metaboonma/MR32-BOT/Presentation/MR32-BOT and KB-IDE 4 page.pdf

14/08/63

1

# การใช้ KB-IDE ในการเขียนโปรแกรมควบคุมหุ่นยนต์ ด้วยบอร์ด MR32-BOT

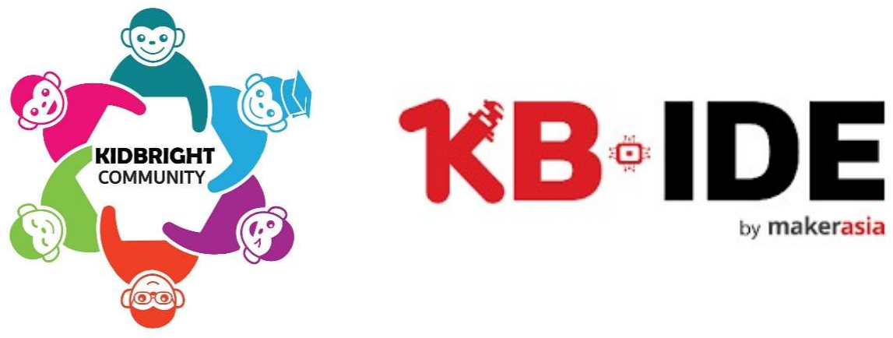
[picture p1: figure]

BY MR. META BOONMA | MTB
POWERED by | MICROTECHBEING
Introduction

## ประวัติผู้บรรยาย

ชือ นายเมธา บุญมา (Mr. Meta Boonma)
การศึกษา 2018 : มหาวิทยาลัยเทคโนโลยีพระจอมเกล้าพระนครเหนือ | | ป.ตรี เทคโนโลยีวิศวกรรมอิเล็กทรอนิกส์คอมพิวเตอร์
2016 : วิทยาลัยเทคนิคสมุทรสงคราม | | ปวส. เทคโนโลยีระบบโทรคมนาคม
2013 : วิทยาลัยเทคนิคสมทุ รสงคราม | | ปวช. ช่างอิเลก็ ทรอนิกส์ ประสบการทํางาน
- R&D Engineer | @ FORTH TRACKING SYSTEM Co., Ltd.
- IoT Software Engineer | @ FreewillFX Co.,Ltd. | (ปจจุบัน) - Project manager | @ Medical Cannabis Monitoring Platform powered by MTB | (ปจจุบัน) ผลงาน - รางวัลรองชนะเลิศการแขง่ ขนั หุ่นยนต์ABU Robocon Contest Thailand ในป 2014 (Hoilod Robot team) - ออกแบบและพัฒนา Embedded system, Robotic board ด้วย Microcontroller, SoC, SiP - การใชช้ ิปประมวลผล DSP เพือควบคุมระบบเสียง(Sound System) ด้วย Android application
- ออกแบบ Power Management และ LOW Power สําหรับ Smart devices - ออกแบบผลิตภัณฑ์ Smart Electronic ด้วยระบบปฏิบัติการ Linux, RTOS (GPS, Fingerprint scan, Face recognition) - ออกแบบและพัฒนาอุปกรณ์ IoT บนเทคโนโลยีการสือสารข้อมูล LORA, NB-IoT, 3G/4G, WLAN - พัฒนา IoT Platform ในชือ Medical Cannabis Monitoring Platform powered by MTB | MTB
POWERED by | MICROTECHBEING

Introduction

ทําความรู้จักกับ KidBright

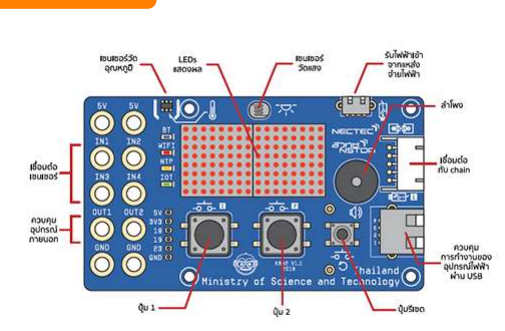
[picture p2: figure]

KidBrightเปนบอร์ดส่งเสรมิ การเรียนรู้พืนฐานของ การเขยีนโปรแกรม (Programming)
จุดเริมต้นจากโครงการสือการสอนโปรแกรมมิงในโรงเรียน (Coding at School Project) ของ กระทรวงวิทยาศาสตร์และเทคโนโลยี ซึงมีจุดม่งุ หมายในการพัฒนาศักยภาพระหว่าง ความคิดเชงิตรรกะ และความคดิ ริเรมสร้างสรรค์ ิ | ในลักษณะการเรียนรู้แบบ learn and play

## MTB

POWERED by | MICROTECHBEING

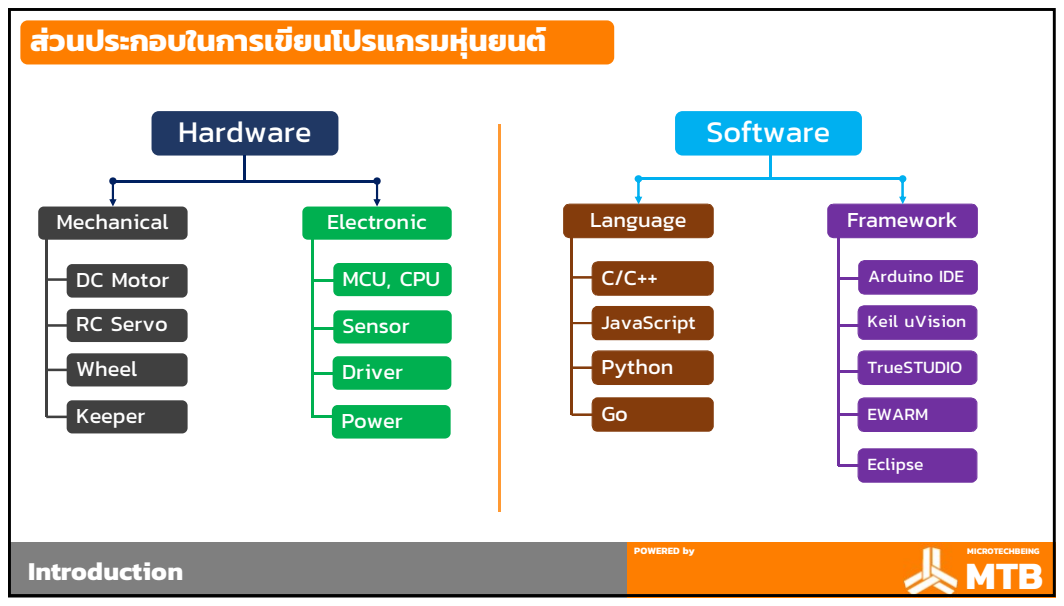
[picture p3: figure]
Introduction; ส่วนประกอบในการเขยีนโปรแกรมหุ่นยนต์; MTB; POWERED by; MICROTECHBEING; Hardware; Software; Mechanical; Electronic; DC Motor RC Servo Wheel Keeper; MCU, CPU Sensor; Power; Driver; Language; Framework; JavaScript Python

Go | Arduino IDE Keil uVision EWARM TrueSTUDIO Eclipse

2

Introduction

ทําความรู้จักกับ ESP32

## MTB

POWERED by | MICROTECHBEING
ESP32 เปนชิปไมโครคอนโทรลเลอรท์ มาพร้อม ี | WiFi และ Bluetooth 4.2 แบบ SoC (System on Chip) สามารถเขียน
โปรแกรมลงไปได้เลยไม่จําเปนต้องใช้ MCU อืนมาควบคุม ถูกพัฒนาโดยบริษัท Espressif โดย CPU ใช้สถาปตยกรรม Tensilica LX6 แบบ 2 แกนสมอง สัญญาณนาิกา 240MHz มีGPIO สําหรับต่อใช้งานจํานวน 32 ช่อง

สเปคของ ESP32
------------------------------------------------------------------------ - ซีพียูใช้สถาปตยกรรม Tensilica LX6 แบบ 2 แกนสมอง สัญญาณนาิกา 240MHz
- มีแรมในตัว 512KB
- รองรับการเชือมต่อรอมภายนอกสูงสุด 16MB
- มาพร้อมกับ WiFi มาตรฐาน 802.11 b/g/n รองรับการใช้งานทังใน
โหมด Station softAP และ Wi-Fi direct - มีบลูทูธในตวั รองรบั การใช้งานในโหมด 2.0 และโหมด 4.0 BLE
- มี GPIO จํานวน 32 ช่อง
- รองรับ UART จํานวน 3 ช่อง
- รองรับ SPI จํานวน 3 ชอ่ ง
- รองรับ I²C จํานวน 2 ชอ่ ง
- รองรับ ADC จํานวน 12 ช่อง
- รองรับ DAC จํานวน 2 ช่อง
- รองรับ I²S จํานวน 2 ช่อง
- รองรับ PWM / Timer ทุกช่อง
- รองรับการเชือมต่อกับ SD-Card

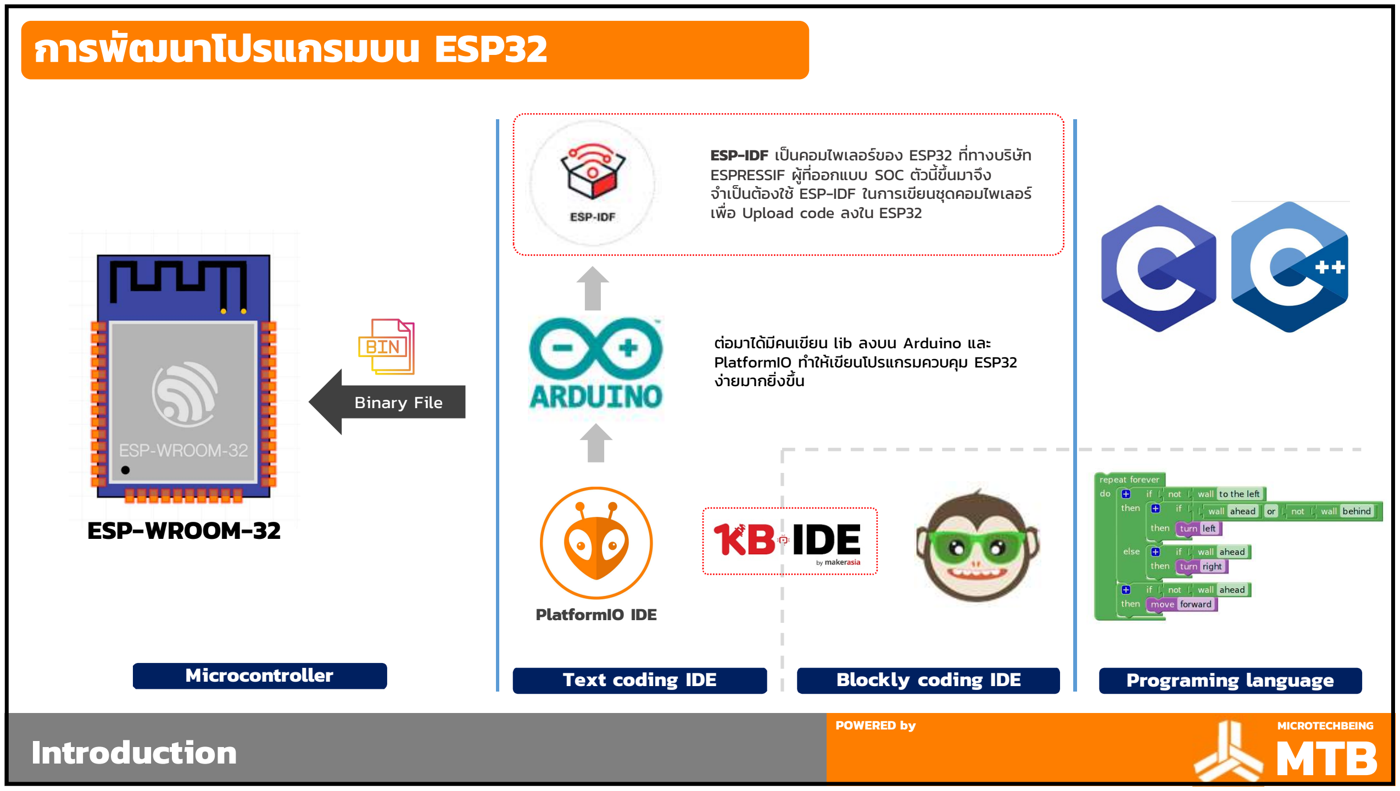
[picture p4: figure]
Introduction; การพัฒนาโปรแกรมบน ESP32; MTB; POWERED by; MICROTECHBEING; ESP-WROOM-32; PlatformIO IDE; Binary File Microcontroller; Text coding IDE; Blockly coding IDE; Programing language

ESP-IDF เปน คอมไพเลอรข์ อง ESP32 ทีทางบริษัท ESPRESSIF ผู้ทีออกแบบ SOC ตัวนีขึนมาจึง จําเปนต้องใช้ ESP-IDF ในการเขียนชุดคอมไพเลอร์ เพือ Upload code ลงใน ESP32 ต่อมาได้มีคนเขียน lib ลงบน Arduino และ PlatformIO ทําให้เขียนโปรแกรมควบคุม ESP32 ง่ายมากยิงขึน

Introduction

## ทาํ ความรู้จักกับ KB-IDE

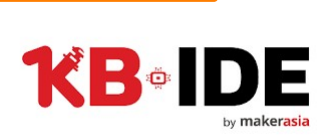
[picture p5: figure]

KB-IDE เปนโปรแกรมสัญชาตไิทยสําหรับใช้เขียนโปรแกรมบนบอร์ด IoT (และ SBC ด้วยในอนาคต) โดยเปาหมายการ ออกแบบคือ IDE สําหรับทุกคน ทกุ ระดับ เด็กๆ สามารถใช้Block Programming ได้มอื โปรสามารถใช้Code Editor ได้

เปน IDE ทีใช้ไดก้ ับทุกบอร์ดในตลาด ทสําคัญคือเป ี | น IDE ที Hackable นันหมายความว่านักพัฒนาสามารถเปลียนแปลง
หรือต่อยอด IDE ได้ไม่ว่าจะเปน Board Manager หรือ Plug-in ต่าง ๆ เนืองจาก KB-IDEเปน Open Source และ Open Architecture. | MTB
POWERED by | MICROTECHBEING

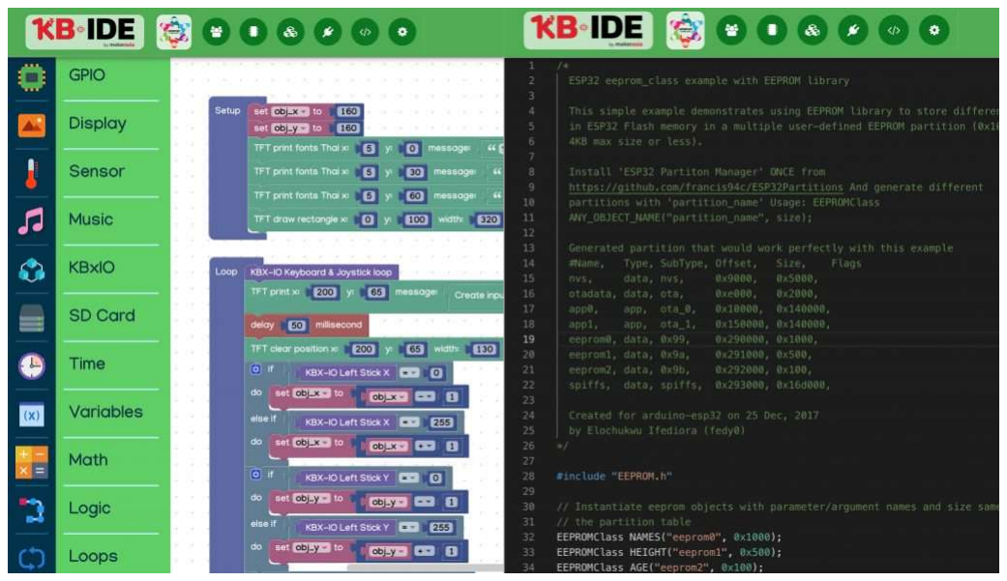
[picture p6: figure]

Introduction

ความสามมารถของ KB-IDE | - เขียนโปรแกรมไดท้ ังในแบบ Blocks Programming และ Code Editor - เพิม Hardware Board ได้ใน Board Manager - เพิม Framework ในการเขียนโปรแกรมได้ (ตอนนี support ESP-IDF และ Arduino) - เพิม Plugins และ Library ได้ - คอมไพล์เปน Native Code ทําให้ไม่มีข้อจํากดั ในด้าน ความเร็ว และสามารถคอมไพล์ได้เร็วกวา่ IDE ใน ตลาดปจจุบนั มากรวมทง ั Arduino IDE
- เครืองช่วยในการเขียนโปรแกรมต่าง ๆ เช่น Serial Console และ Serial Graph ทีพรอ้ มใช้งาน
- สามารถใช้ได้ทัง Mac, Windows และ Linux
- ตัวอย่างและ Tutorial พรอ้ มใช้งาน | MTB
POWERED by | MICROTECHBEING

3

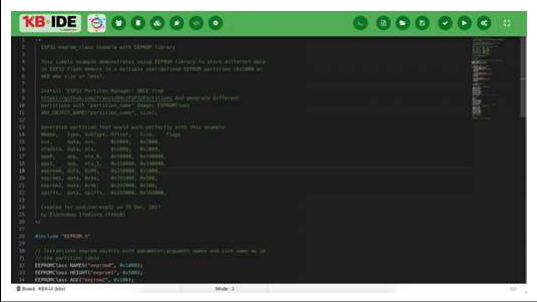
[picture p7: figure]

Introduction

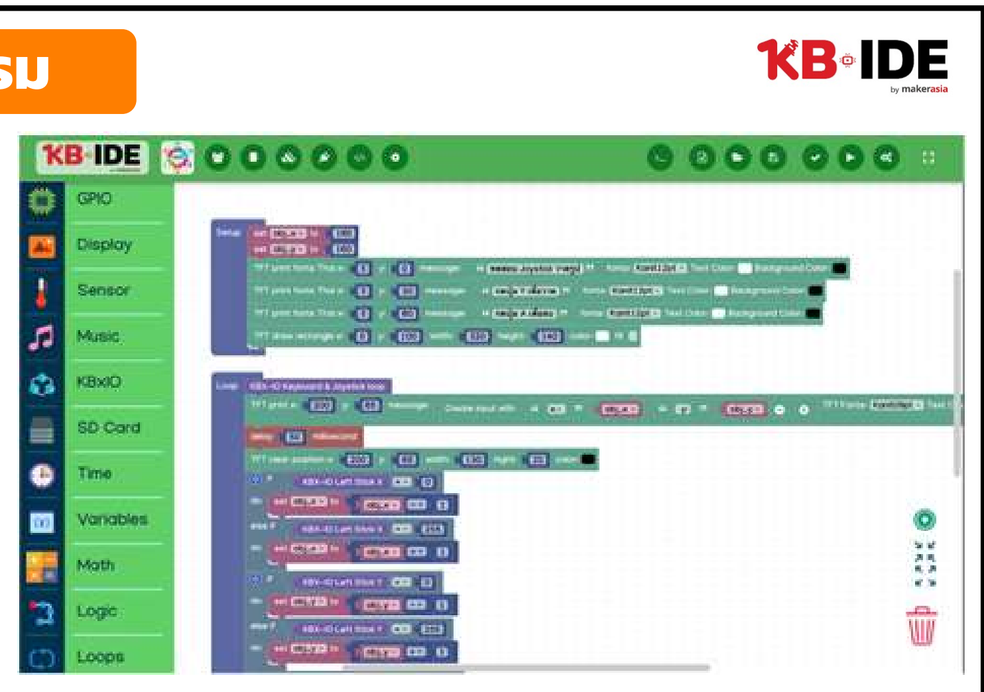
[picture p8: figure]

ความสามารถในแต่โหมดการเขียนโปรแกรม

## MTB

POWERED by | MICROTECHBEING

Text Programing
------------------------------------------------ – Speed up coding by converting C/C++ from block. – Line error hint, indicate and report lines with error. – 50+ editor themes, dark/light, select your personal preference. – Fast switch block & code mode. – External package, add a more powerful tool. | Block Programming

----------------------------------------------- – 100% no hardcoding, just drag & drop with block connection. – Easy and Intuitive. – Basic & Advance block coverage 99% of the code that you write. – Various helping blocks, Images, Music, Text-to-speech. – Have fun in exploring with your creativity. – Speed up text-coding, all blocks are 100% convertible ready-compile C/C++

Introduction

## ทําความร้จู ักกับบอร์ด MR32-BOT

## MTB

POWERED by | MICROTECHBEING

บอร์ดไมโครคอนโทรเลอร์MR32-BOT เปนบอร์ดทีพัฒนาขึนมาด้วยวัตถุประสงค์ที อยากใหก้ ารสร้างห่นุ ยนต์ขนาดเล็กง่ายมากยงขึ ิ นโดยไม่จาํ เปนต้องหาบอรด์ อืนๆมาตอ่ พ่วงกนั เพือทีจะลดปญหาของการเชือมต่อสายไฟผิดพลาด, ตอ่ แบตเตอรีผิดขัว, ขนาดของบอร์ด สําเร็จรูปในท้องตลาดมขี นาดใหญ่และราคาสูง
บอร์ดไมโครคอนโทรเลอร์ MR32-BOT จึงได้ถูกออกแบบมาให้ช่วยแก้ปญหาทีกล่าวมาใน ตอนต้นและยังช่วยลดเวลาในการพัฒนาโปรแกรมลงค่อนข้างมาก
ESP-WROOM-32 BT / WiFi | 2 Channel Motor driver RC Server Analog input Switch button USB to TTL programmable

Battery 3500mAh

Battery Charger ⁵V boost converter 2.1A LDO 3.3V 800mA ON/OFF Controller

5V/2.1A 3.3V 5V USB

MR32-BOT Architecture MR32-BOT Rev. A

Introduction

## ขาต่างๆของ MR32-BOT

## MTB

POWERED by | MICROTECHBEING GPIO¹⁸ GPIO¹⁹ GPIO²³

GPIO15 GPIO14 GPIO13 GPIO14 GPIO36 GPIO39 GPIO34 GPIO35 GPIO32 +3V3 GND ADC4 ADC7 ADC6 ADC3 ADC0

SERVO GPIO16 GND | +5V | GPIO17 GND | +5V | DC MOTOR2 LED DIR MOTOR2 DC MOTOR1 LED DIR MOTOR1 SWITCH POWER ON/OFF Micro USB

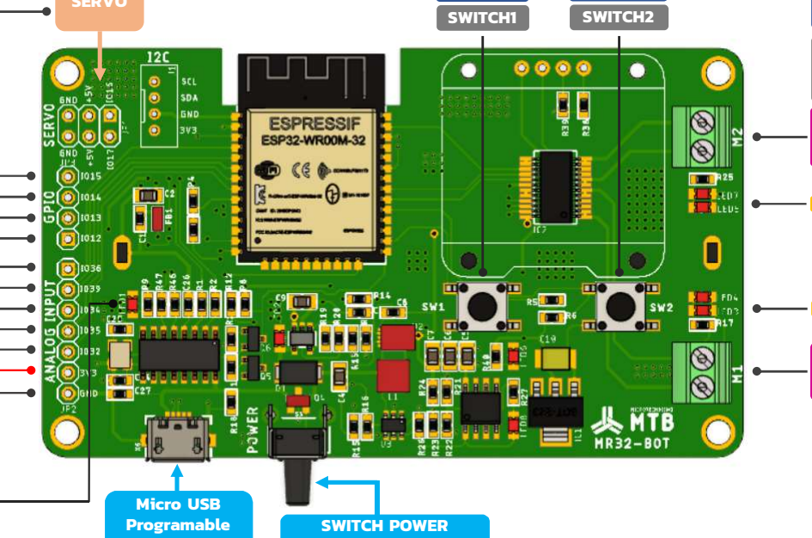
[picture p9: figure]

Programable and charge

SWITCH1 GPIO4 | SWITCH2 GPIO5 | A | PWM B A | PWM B GPIO²⁵ GPIO²⁶ GPIO²⁷ GPIO2 | LED BUITIN

BATTERY MONITOR GPIO33 ADC5 Voltage divider (R1=R2=22K) ** VBAT = VBAT / 2 **

KB-IDE

## การติดตังโปรแกรม KB-IDE https://kbide.org/

## MTB

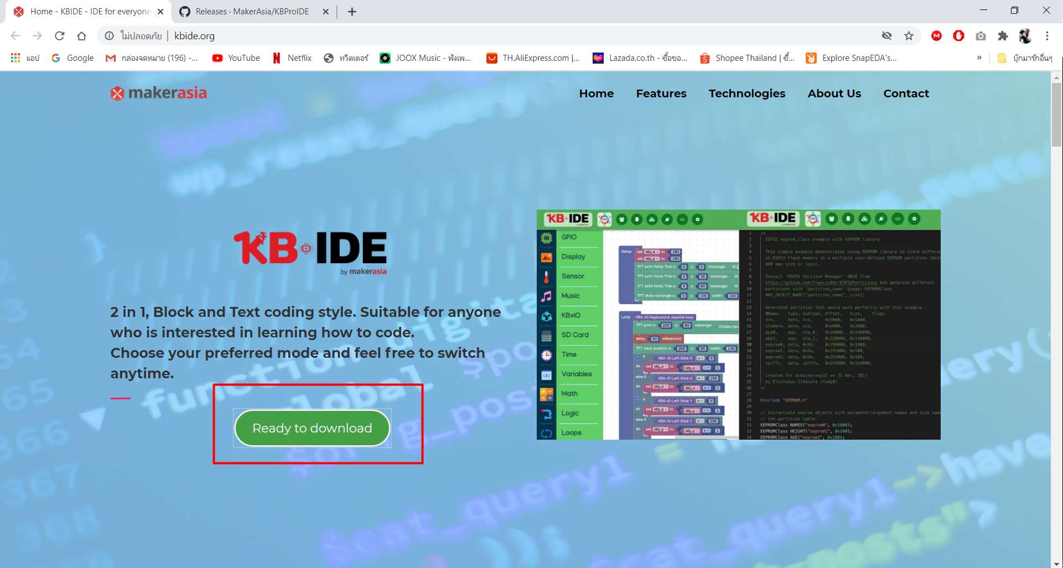
[picture p10: figure]

POWERED by | MICROTECHBEING

## การติดตังโปรแกรม KB-IDE โปรแกรม KB-IDE

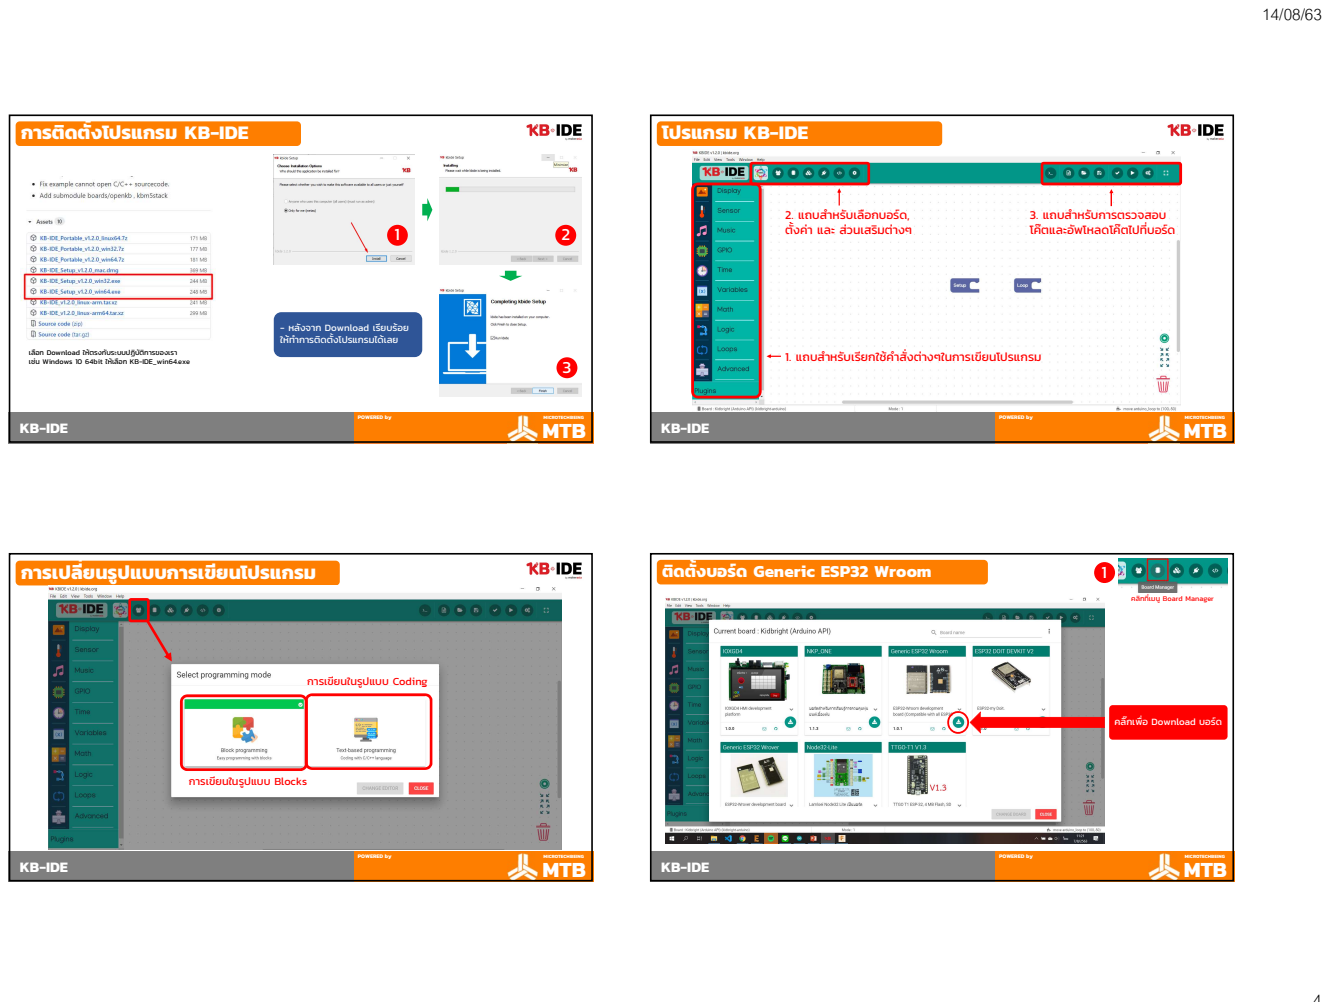
[picture p11: page 4]
KB-IDE; MTB; POWERED by; MICROTECHBEING; ตดิ ตังบอร์ด Generic ESP32 Wroom; คลิกทีเมนู Board Manager คลิกเพือ Download บอร์ด

2. แถบสําหรับเลือกบอร์ด, ตังค่า และ ส่วนเสริมต่างๆ

3. แถบสําหรับการตรวจสอบ
โค๊ตและอัพโหลดโค๊ตไปทีบอร์ด

- หลังจาก Download เรียบร้อย
ให้ทําการตดิ ตงโปรแกรมได้เลย ั

เลือก Download ให้ตรงกับระบบปฏิบัติการของเรา
เช่น Windows 10 64bit ให้เลือก KB-IDE_win64.exe

1. แถบสําหรับเรียกใช้คําสังต่างๆในการเขียนโปรแกรม

การเปลียนรูปแบบการเขียนโปรแกรม

การเขยี นในรูปแบบ Coding

การเขียนในรูปแบบ Blocks

5

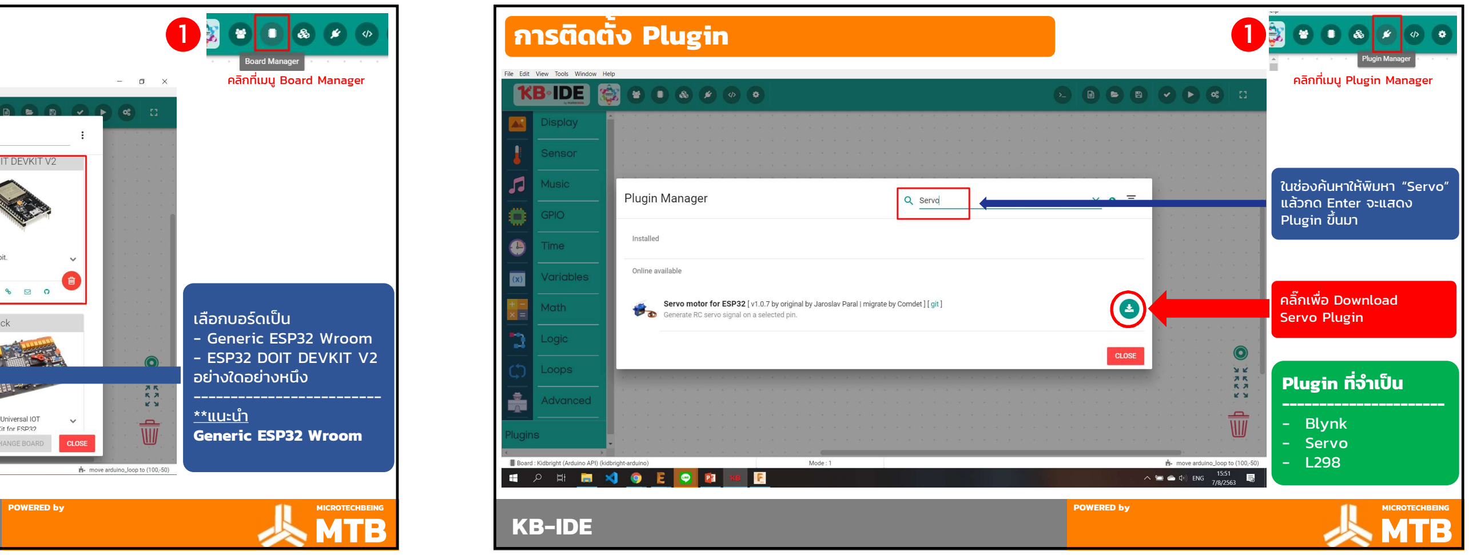
[picture p12: figure]
คลกิ ทเมนู ี; Board Manager; เลือกบอร์ดเปน - Generic ESP32 Wroom; - ESP32 DOIT DEVKIT V2 อย่างใดอย่างหนึง; ------------------------- **แนะนํา Generic ESP32 Wroom; MTB; POWERED by; MICROTECHBEING; KB-IDE; การติดตัง Plugin; คลิกทีเมนู Plugin Manager; คลิกเพือ Download Servo Plugin; ---------------------- - Blynk; - Servo - L298
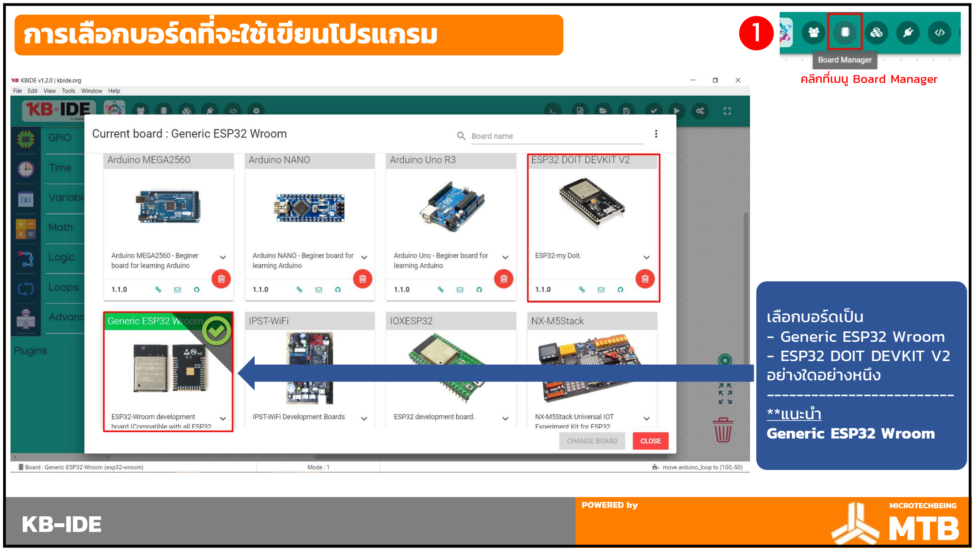
[picture p13: figure]
KB-IDE; การเลือกบอร์ดทีจะใช้เขียนโปรแกรม

ในช่องค้นหาให้พิมหา “Servo” แล้วกด Enter จะแสดง Plugin ขึนมา Plugin ทีจําเปน

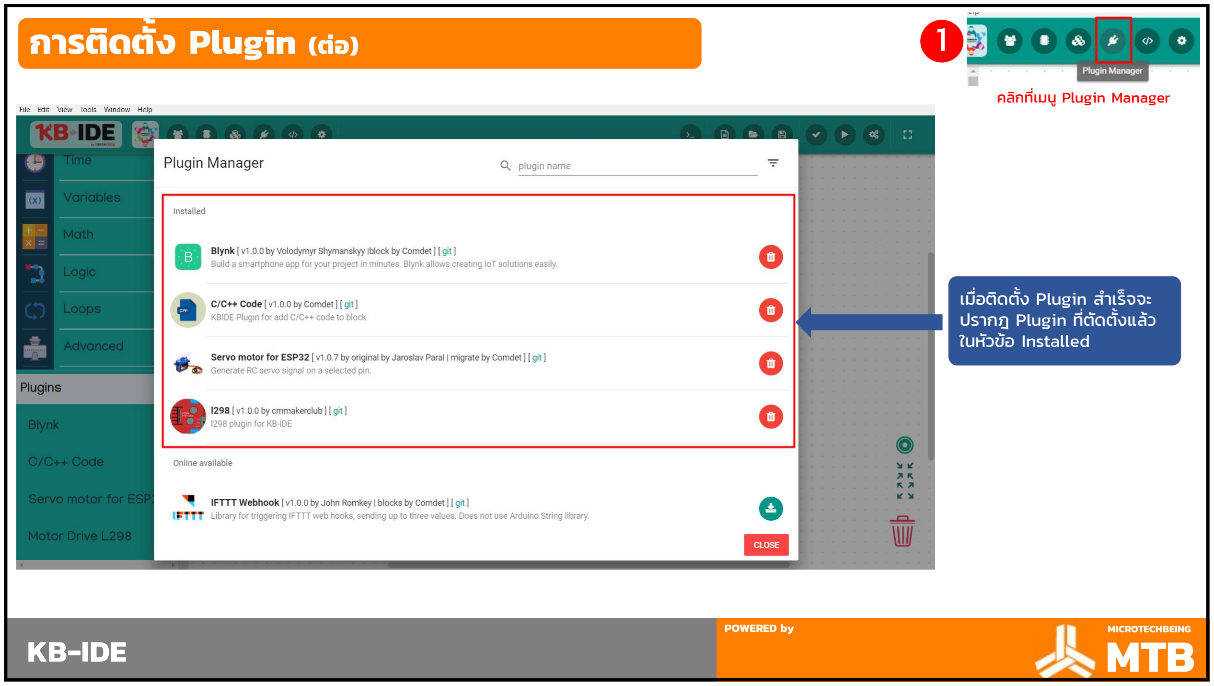
[picture p14: figure]
KB-IDE; การติดตัง Plugin (ต่อ); MTB; POWERED by; MICROTECHBEING; คลกิ ทเมนู ี; Plugin Manager; ในหัวข้อ Installed

เมือติดตัง Plugin สําเร็จจะ ปรากฎ Plugin ทีตัดตังแล้ว

KB-IDE

สรุปขันตอนการติดตังและตังค่าต่างๆ

## MTB

POWERED by | MICROTECHBEING

### 1. ติดตังโปรแกรม KB-IDE สามารถดาวโหลดได้จาก https://kbide.org/ 2. ติดตังบอร์ด Generic ESP32 Wroom 3. เลือกบอร์ดทีเราจะใช้ในการขยี นโปรแกรมในทนี ี คือ Generic ESP32 Wroom 4. ติดตัง Plugin ทีจําเปนต้องใช้ - Blynk

- Servo motor for ESP32
- L298

## ** หากทําการติดตังครบแลว้มาเริมเขียนโปรแกรมกัน **

6

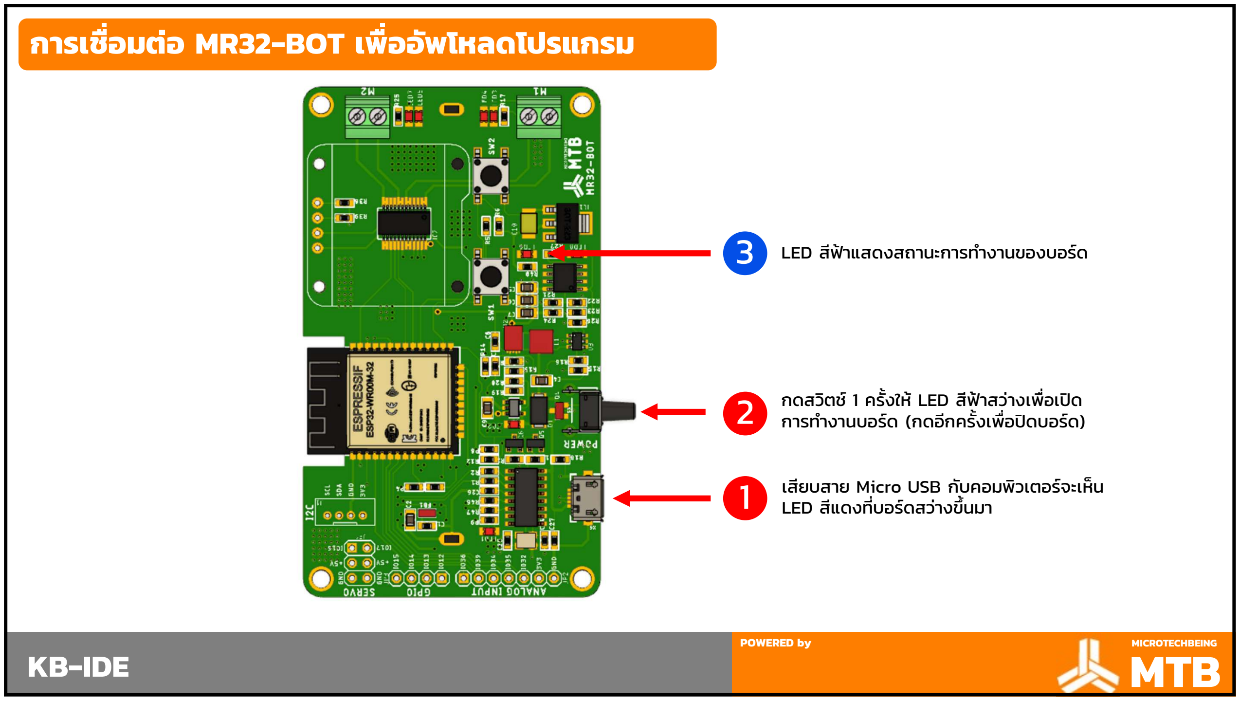
[picture p15: figure]
KB-IDE; การเชือมต่อ MR32-BOT เพืออัพโหลดโปรแกรม; MTB; POWERED by; MICROTECHBEING; 2 การทํางานบอร์ด (กดอีกครังเพือปดบอร์ด); 3 LED สีฟาแสดงสถานะการทํางานของบอร์ด 
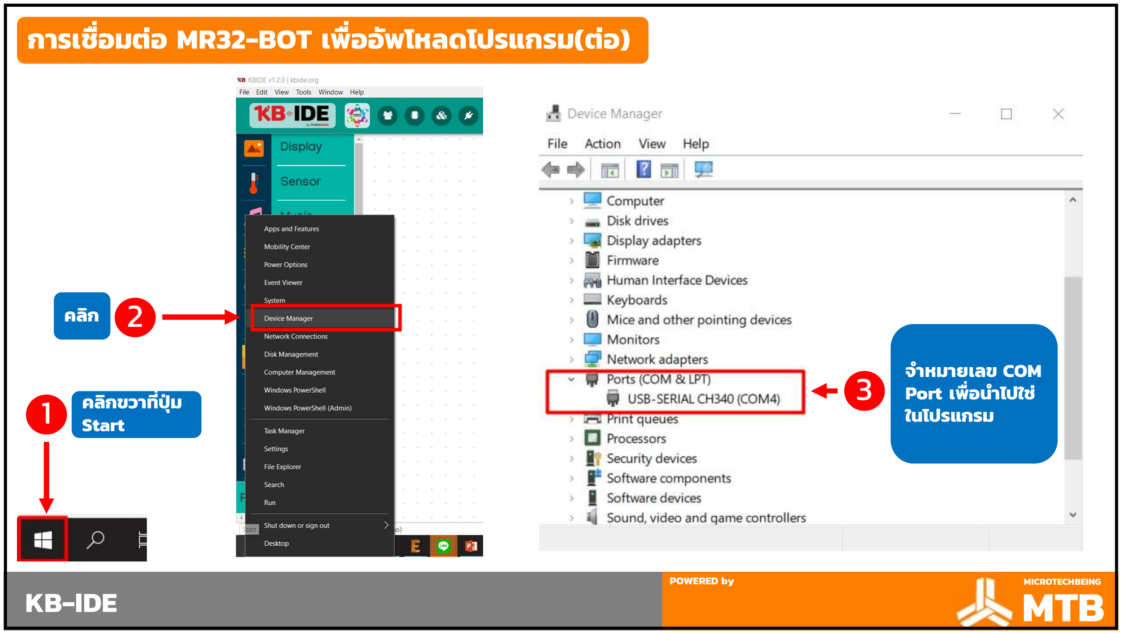
[picture p16: figure]
KB-IDE; การเชือมต่อ MR32-BOT เพืออพั โหลดโปรแกรม(ต่อ); MTB; POWERED by; MICROTECHBEING; คลิกขวาทีปุม Start 1 คลิก 2; จําหมายเลข COM Port เพือนําไปใช่ ในโปรแกรม

1 เสียบสาย Micro USB กับคอมพิวเตอร์จะเห็น LED สีแดงทีบอร์ดสว่างขึนมา กดสวิตช์1 ครังให้ LED สีฟาสว่างเพื อเปด

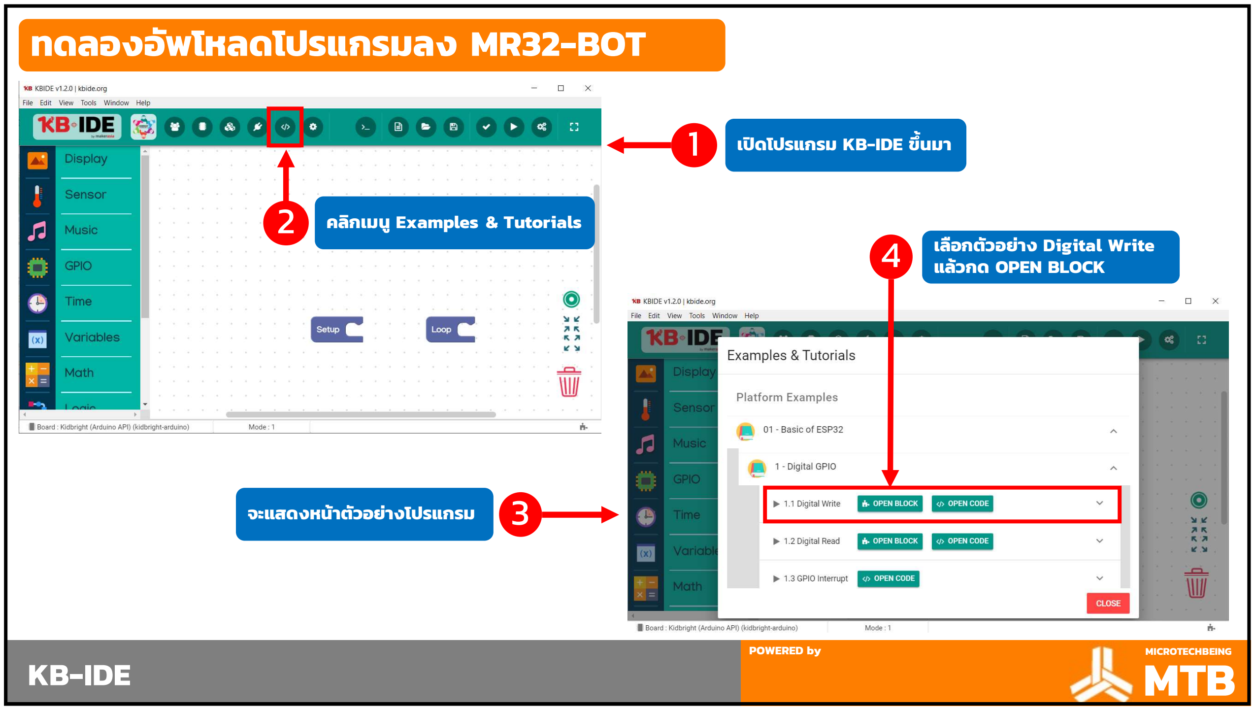
[picture p17: figure]
KB-IDE; ทดลองอัพโหลดโปรแกรมลง MR32-BOT; MTB; POWERED by; MICROTECHBEING; คลิกเมนู Examples & Tutorials; 1 เปดโปรแกรม KB-IDE ขึนมา 2; จะแสดงหน้าตัวอย่างโปรแกรม

### 4 เลือกตัวอย่าง Digital Write แล้วกด OPEN BLOCK

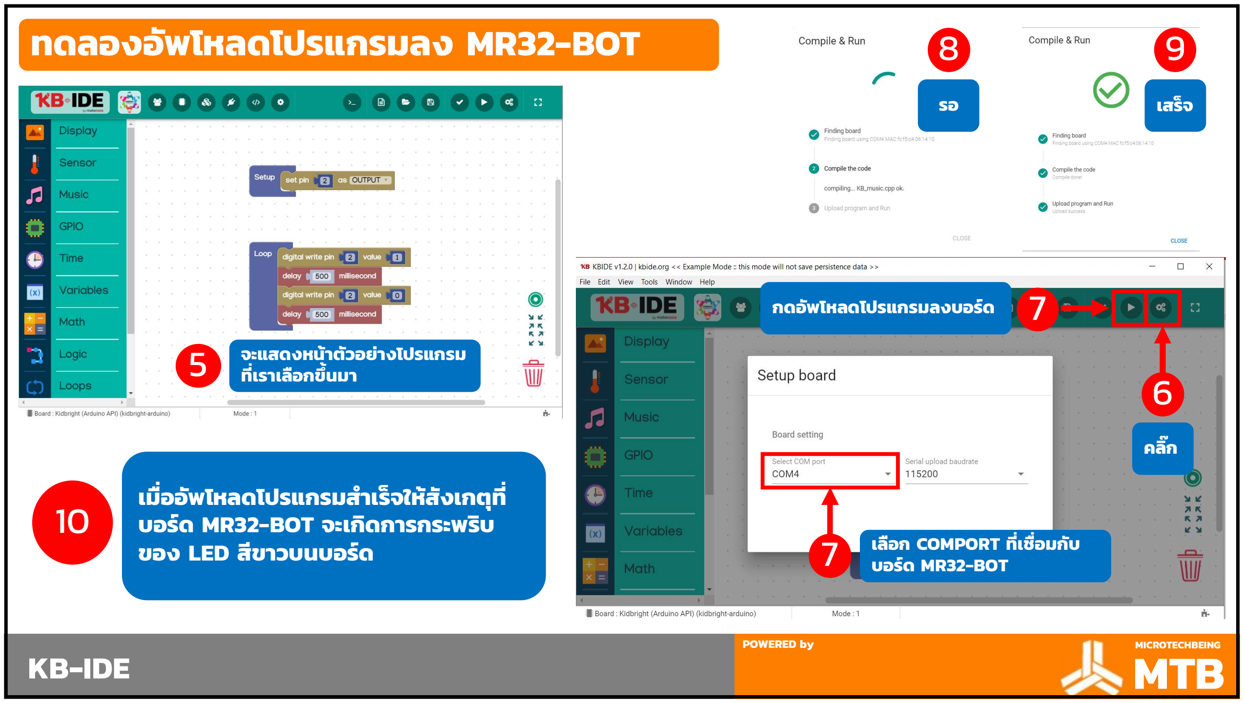
[picture p18: figure]
KB-IDE; ทดลองอัพโหลดโปรแกรมลง MR32-BOT; MTB; POWERED by; MICROTECHBEING; จะแสดงหน้าตัวอย่างโปรแกรม 5 ทีเราเลือกขึนมา; 7 เลือก COMPORT ทีเชือมกับ; บอร์ด MR32-BOT; กดอัพโหลดโปรแกรมลงบอร์ด; เสร็จ

เมืออพั โหลดโปรแกรมสําเร็จให้สังเกตุที บอร์ด MR32-BOT จะเกิดการกระพรบิ ของ LED สีขาวบนบอร์ด

7

## MTB

POWERED by | MICROTECHBEING

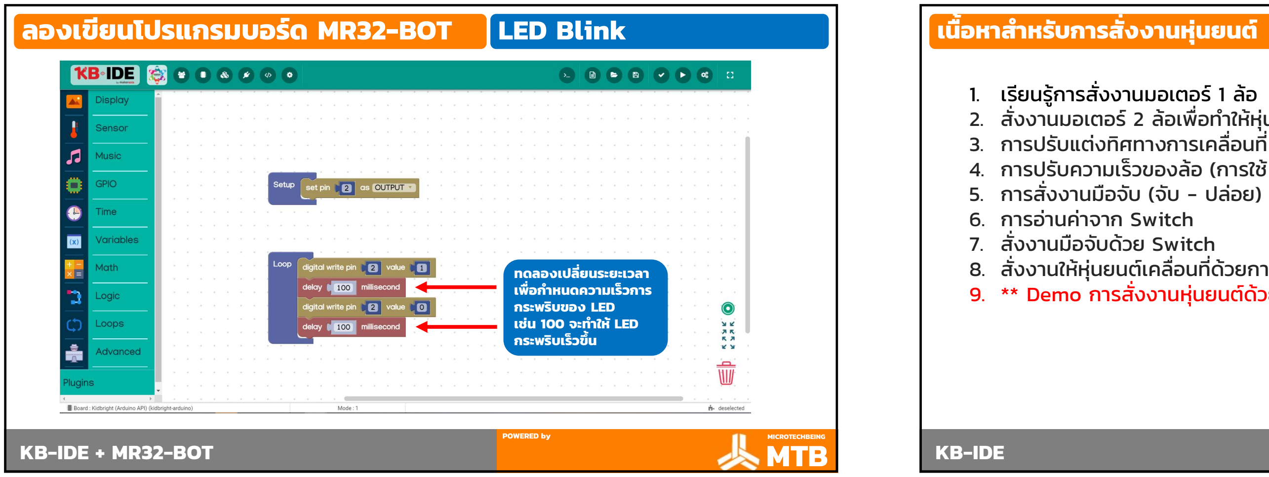
[picture p19: figure]
KB-IDE + MR32-BOT; ลองเขียนโปรแกรมบอรด์ MR32-BOT; MTB; POWERED by; MICROTECHBEING; LED Blink; ทดลองเปลียนระยะเวลา เพือกําหนดความเร็วการ กระพริบของ LED; เช่น 100 จะทําให้ LED กระพริบเร็วขึน; KB-IDE; เนือหาสําหรับการสังงานหุ่นยนต์; 1. เรยี นรู้การสังงานมอเตอร์ 1 ล้อ; 5. การสังงานมือจบั (จับ - ปล่อย) 6. การอา่ นค่าจาก Switch 7. สังงานมอื จับด้วย Switch

2. สังงานมอเตอร์ 2 ล้อเพือทําให้หุ่นยนต์เคลือนที 3. การปรับแต่งทิศทางการเคลือนที 4. การปรับความเร็วของล้อ (การใช้ PWM)

### 8. สังงานให้หุ่นยนต์เคลือนทีด้วยการกด Switch

9. ** Demo การสังงานหุ่นยนต์ด้วย Smart phone

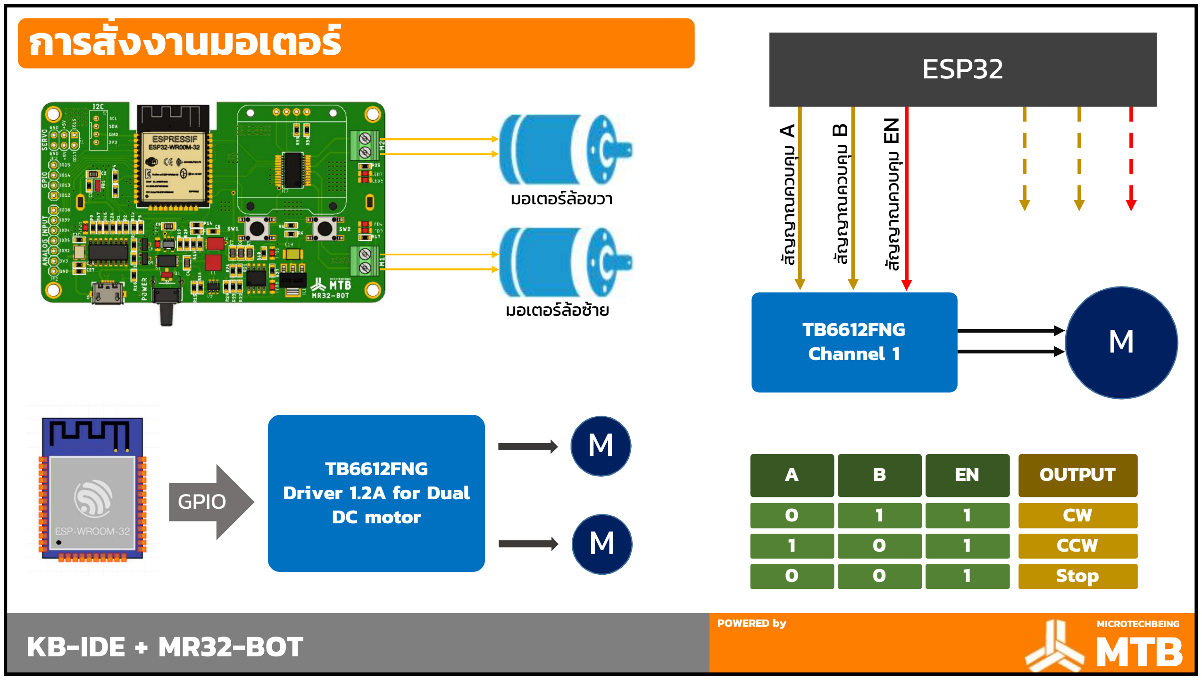
[picture p20: figure]
KB-IDE + MR32-BOT; การสังงานมอเตอร์; MTB; POWERED by; MICROTECHBEING; มอเตอร์ล้อขวา มอเตอร์ล้อซ้าย; ESP32; TB6612FNG; Channel 1; M สัญญาณควบคุม A; สัญญาณควบคุม B; สัญญาณควบคุม EN A; OUTPUT 0; CCW; Stop

TB6612FNG Driver 1.2A for Dual DC motor GPIO | M

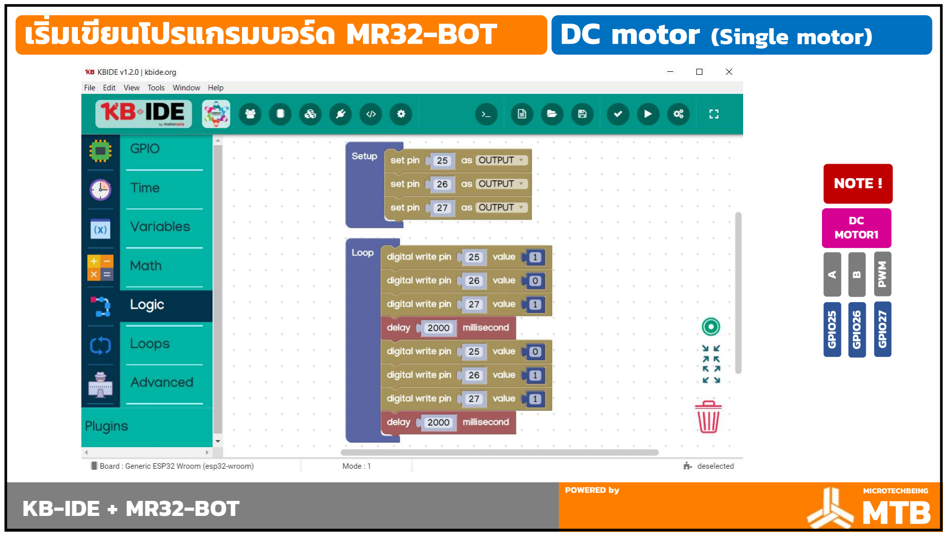
[picture p21: figure]
KB-IDE + MR32-BOT; เริมเขียนโปรแกรมบอร์ด MR32-BOT; MTB; POWERED by; MICROTECHBEING

DC motor (Single motor) DC MOTOR1 A | PWM B GPIO²⁵ GPIO²⁶ GPIO²⁷ NOTE !

## เริมเขียนโปรแกรมบอร์ด MR32-BOT

## การเคลือนทีของหุ่นยนต์

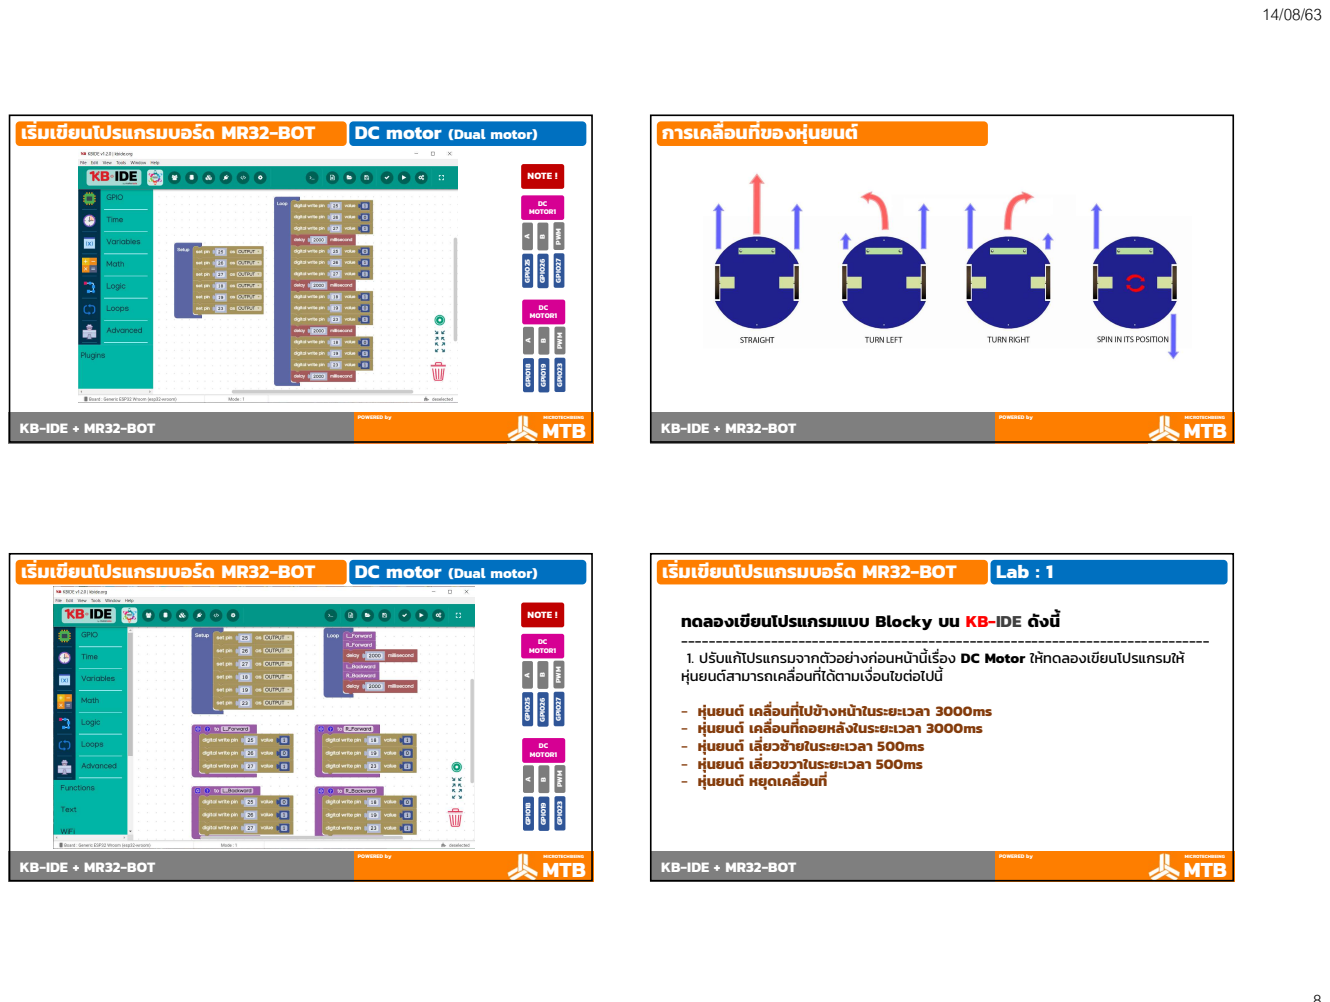
[picture p22: page 8]
MTB; POWERED by; MICROTECHBEING; DC motor (Dual motor) DC MOTOR1 A; PWM B GPIO²⁵ GPIO²⁶ GPIO²⁷ NOTE ! DC MOTOR1 A; PWM B GPIO¹⁸ GPIO¹⁹ GPIO²³; Lab : 1; หุ่นยนต์สามารถเคลือนทีได้ตามเงือนไขต่อไปนี ;  - ห่นุ ยนต์เคลอนที ื ไปข้างหนา้ในระยะเวลา 3000ms; - ห่นุ ยนต์เลยวซ้ายในระยะเวลา ี; - ห่นุ ยนต์เลยวขวาในระยะเวลา ี

KB-IDE + MR32-BOT

เริมเขียนโปรแกรมบอร์ด MR32-BOT

ทดลองเขียนโปรแกรมแบบ Blocky บน KB-IDE ดงั นี
1. ปรบั แก้โปรแกรมจากตัวอยา่ งก่อนหน้านเรื ี อง DC Motor ให้ทดลองเขียนโปรแกรมให้

- ห่นุ ยนต์เคลอนที ื ถอยหลังในระยะเวลา 3000ms
- ห่นุ ยนต์หยุดเคลอนที ื

## เริมเขียนโปรแกรมบอร์ด MR32-BOT

## เริมเขียนโปรแกรมบอร์ด MR32-BOT

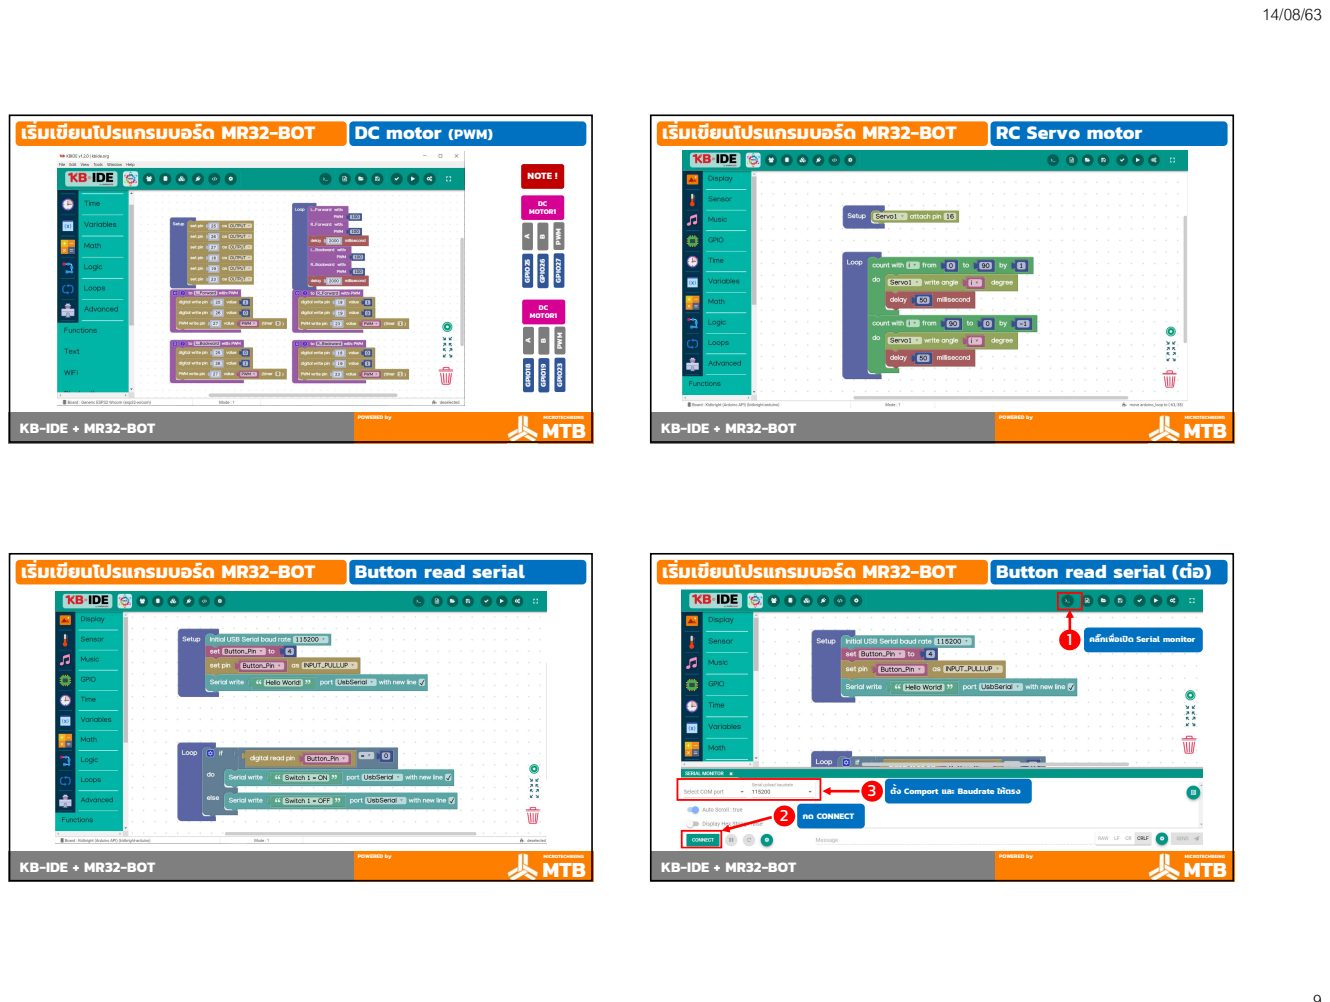
[picture p23: page 9]
MTB; POWERED by; MICROTECHBEING; DC motor (PWM); DC MOTOR1 A; PWM B GPIO²⁵ GPIO²⁶ GPIO²⁷ NOTE ! DC MOTOR1 A; PWM B GPIO¹⁸ GPIO¹⁹ GPIO²³; 2 กด CONNECT

RC Servo motor

KB-IDE + MR32-BOT

เริมเขียนโปรแกรมบอร์ด MR32-BOT

Button read serial

Button read serial (ต่อ)

1 คลิกเพือเปด Serial monitor

3 ตัง Comport และ Baudrate ให้ตรง

10

KB-IDE + MR32-BOT

## เริมเขียนโปรแกรมบอร์ด MR32-BOT

## MTB

POWERED by | MICROTECHBEING

## Lab : 2

ทดลองเขียนโปรแกรมแบบ Blocks บน KB-IDE ดังนี ----------------------------------------------------------------------------- ปรบั แก้โปรแกรมจากตัวอย่างก่อนหน้านเรื ี อง RC Servo และการอ่านค่า Switch ให้สามารถ

ทํางานไดต้ ามเงอืนไขตอ่ ไปนี - กด Switch 1 แล้วมอืจบั - กด Switch 2 แล้วมอืปล่อย

KB-IDE + MR32-BOT

## เริมเขียนโปรแกรมบอร์ด MR32-BOT

## MTB

POWERED by | MICROTECHBEING

## Lab : 3

ทดลองเขียนโปรแกรมแบบ Blocks บน KB-IDE ดงั นี

### 1. ปรบั แก้โปรแกรมจากตัวอยา่ งก่อนหน้านเรื ี อง DC motor และ Switch ให้สามารถทํางาน

ได้ดังตอ่ ไปนี - เมือกด Switch1 = ล้อของหุ่นยนต์หมุนไปด้านหน้า - เมือกด Switch2 = ล้อของหุ่นยนต์หมุนไปด้านหลัง
