metaboonma/MR32-BOT/Mini-32BOT Rev.A Bottom.png

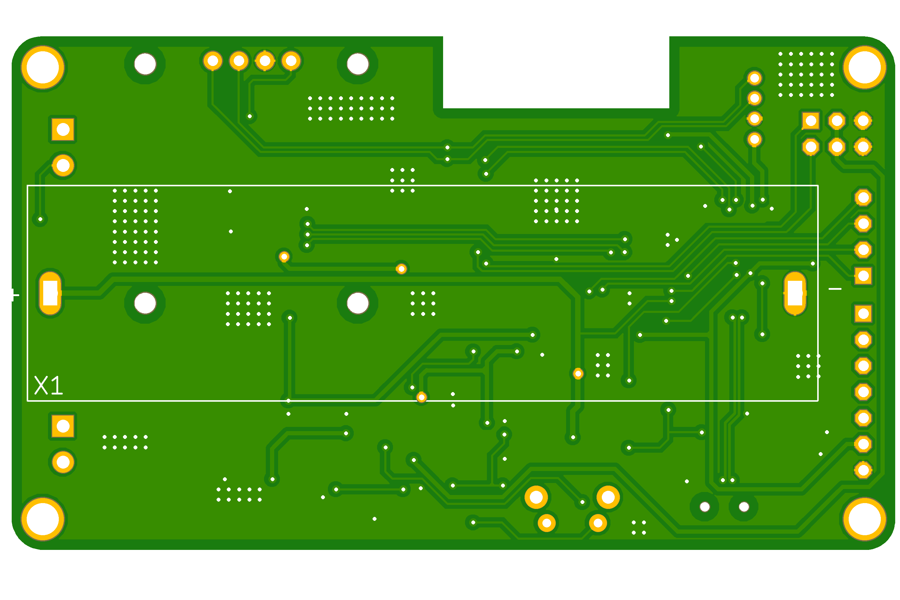
Mini-32BOT Rev.A Bottom.png
