metaboonma/MR32-BOT/MR32-BOT Rev.A.png

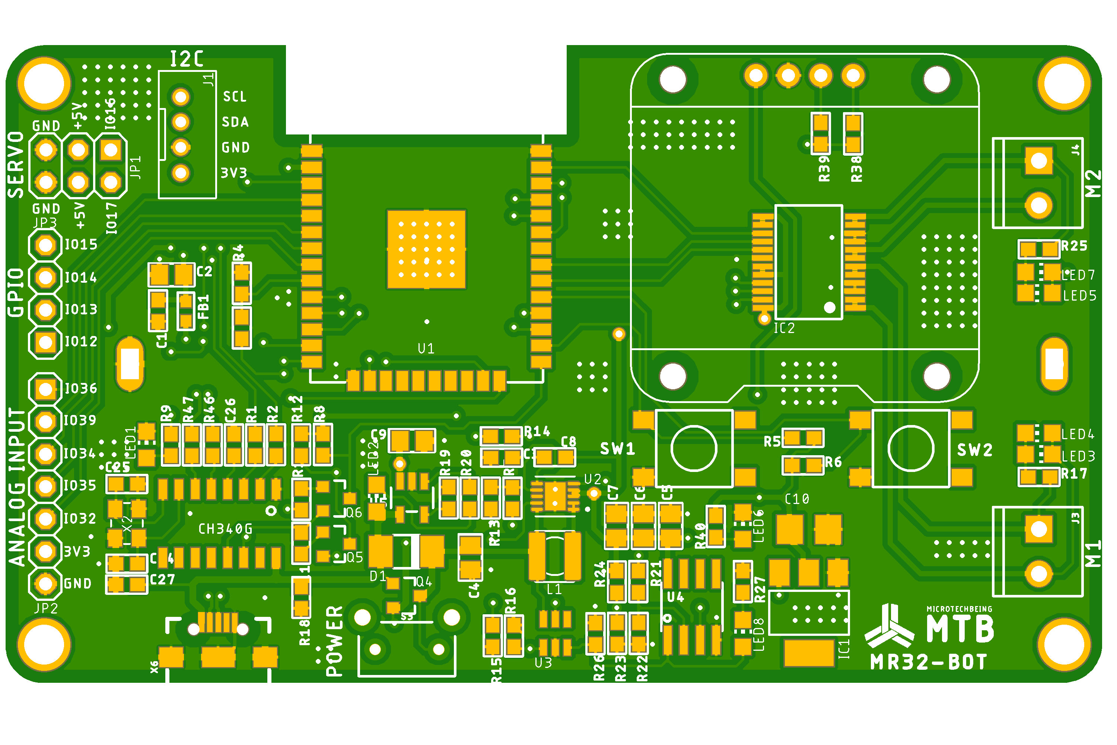
MR32-BOT Rev.A.png
