metaboonma/MR32-BOT/Assembly/JLCSMT_MR32-BOT_BOM.xlsx

Comment | Designator | Footprint | LCSC Part #（optional）
LM358DR | U4 | SOIC8_150MIL | C7950 (https://lcsc.com/product-detail/General-Purpose-Amplifiers_ON-Semicon_LM358DR2G_ON-Semicon-ON-LM358DR2G_C7950.html/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)
100k | R13 | 0603_R | C25803
100nF | C1, C27 | 0603_C | C14663 (https://lcsc.com/product-detail/Multilayer-Ceramic-Capacitors-MLCC-SMD-SMT_100nF-104-10-50V_C14663.html/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)
100uF/6.3V | C10 | CT3528 | C16133 (https://lcsc.com/product-detail/Tantalum-Capacitors_AVX_TAJB107K006RNJ_100uF-107-10-6-3V_C16133.html/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)
10K | R8, R10, R11, R12, R5, R6, R15, R16, R18, R26 | 0603_R | C25804 (https://lcsc.com/product-detail/Chip-Resistor-Surface-Mount_Uniroyal-Elec-0603WAF1002T5E_C25804.html/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)
10nF | C3, C26 | 0603_C | C57112 (https://lcsc.com/product-detail/Multilayer-Ceramic-Capacitors-MLCC-SMD-SMT_10nF-103-10-50V_C57112.html/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)
10uF | C2, C9 | 0805_C | C15850 (https://lcsc.com/product-detail/Multilayer-Ceramic-Capacitors-MLCC-SMD-SMT_SAMSUNG_CL21A106KAYNNNE_10uF-106-10-25V_C15850.html/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)
12k | R21 | 0603_R | C22790 (https://lcsc.com/product-detail/Chip-Resistor-Surface-Mount_Uniroyal-Elec-0603WAF1202T5E_C22790.html/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)
14k | R22 | 0603_R | C22803 (https://lcsc.com/product-detail/Chip-Resistor-Surface-Mount_Uniroyal-Elec-0603WAF1402T5E_C22803.html/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)
18pF | C8 | 0603_C | C1647 (https://lcsc.com/product-detail/Multilayer-Ceramic-Capacitors-MLCC-SMD-SMT_SAMSUNG_CL10C180JB8NNNC_18pF-180-5-50V_C1647.html/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)
1M | R14 | 0603_R | C22935 (https://lcsc.com/product-detail/Chip-Resistor-Surface-Mount_Uniroyal-Elec-0603WAF1004T5E_C22935.html/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)
1k | R17, R20, R25 | 0603_R | C21190 (https://lcsc.com/product-detail/Chip-Resistor-Surface-Mount_Uniroyal-Elec-0603WAF1001T5E_C21190.html/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)
20329 | X6 | USB-B-MICRO-SMD | C40942
22 | R46, R47 | 0603_R | C23345 (https://lcsc.com/product-detail/Chip-Resistor-Surface-Mount_Uniroyal-Elec-0603WAF220JT5E_C23345.html/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)
22k | R3, R4 | 0603_R | C31850 (https://lcsc.com/product-detail/Chip-Resistor-Surface-Mount_Uniroyal-Elec-0603WAF2202T5E_C31850.html/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)
22pF | C24, C25 | 0603_C | C1653 (https://lcsc.com/product-detail/Multilayer-Ceramic-Capacitors-MLCC-SMD-SMT_SAMSUNG_CL10C220JB8NNNC_22pF-220-5-50V_C1653.html/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)
22uF | C4, C5, C6, C7 | 0805_C | C45783 (https://lcsc.com/product-detail/Multilayer-Ceramic-Capacitors-MLCC-SMD-SMT_SAMSUNG_CL21A226MAQNNNE_22uF-226-20-25V_C45783.html/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)
2k | R19 | 0603_R | C22975 (https://lcsc.com/product-detail/Chip-Resistor-Surface-Mount_Uniroyal-Elec-0603WAF2001T5E_C22975.html/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)
330 | R9, R27, R40 | 0603_R | C23138 (https://lcsc.com/product-detail/Chip-Resistor-Surface-Mount_Uniroyal-Elec-0603WAF3300T5E_C23138.html/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)
34k | R23 | 0603_R | C23008 (https://lcsc.com/product-detail/Chip-Resistor-Surface-Mount_Uniroyal-Elec-0603WAF3402T5E_C23008.html/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)
4.7K | R38, R39 | 0603_R | C23162 (https://lcsc.com/product-detail/Chip-Resistor-Surface-Mount_Uniroyal-Elec-0603WAF4701T5E_C23162.html/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)
402k | R7 | 0603_R | C23162 (https://lcsc.com/product-detail/Chip-Resistor-Surface-Mount_Uniroyal-Elec-0603WAF4701T5E_C23162.html/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)
470 | R1, R2 | 0603_R | C23179 (https://lcsc.com/product-detail/Chip-Resistor-Surface-Mount_Uniroyal-Elec-0603WAF4700T5E_C23179.html/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)
51k | R24 | 0603_R | C23196 (https://lcsc.com/product-detail/Chip-Resistor-Surface-Mount_Uniroyal-Elec-0603WAF5102T5E_C23196.html/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)
BC817 | Q5, Q6 | SOT23-3 | C118725 (https://lcsc.com/product-detail/Transistors-NPN-PNP_BC817-25-6B_C118725.html/?href=jlc-SMT)
BLM18SG700TN1D | FB1 | _0603 | C85831
BLUE | LED6 | CHIP-LED0805 | C2293 (https://lcsc.com/product-detail/Light-Emitting-Diodes-LED_Hubei-KENTO-Elec-Blue-light_C2293.html/?href=jlc-SMT)
CH340G | U$24 | SOIC16 | C14267 (https://lcsc.com/product-detail/USB_CH340G_C14267.html/?href=jlc-SMT)
ESP-WROOM-32 | U1 | ESP-WROOM-32 | C95209
GRN | LED3, LED5 | CHIP-LED0805 | C2297 (https://lcsc.com/product-detail/Light-Emitting-Diodes-LED_Green-0805-Iv-207-249-mcd-atIF-20mA_C2297.html/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)
MAX16054AZTT | U3 | 21-0114C | C79401 (https://lcsc.com/product-detail/PMIC-AC-DC-Converters_MAXIM_MAX16054AZT-T_MAX16054AZT-T_C79401.html/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)
MCP73831T | U5 | SOT23-5 | C14879 (https://lcsc.com/product-detail/PMIC-Battery-Management_MICROCHIP_MCP73831T-2ATI-OT_MCP73831T-2ATI-OT_C14879.html/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)
RED | LED2, LED4, LED7 | CHIP-LED0805 | C84256 (https://lcsc.com/product-detail/Light-Emitting-Diodes-LED_Red-LED-SMDLED-80-180mcd_C84256.html/?href=jlc-SMT)
REG1117 | IC1 | SOT223 | C6186 (https://lcsc.com/product-detail/Low-Dropout-Regulators-LDO_AMS_AMS1117-3-3_AMS1117-3-3_C6186.html/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)
SI2301CDS-T1-GE3 | Q4 | SOT23-3 | C10487 (https://lcsc.com/product-detail/MOSFET_Vishay-Intertech_SI2301CDS-T1-GE3_Vishay-Intertech-SI2301CDS-T1-GE3_C10487.html/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)
SS34 | D1 | DO-214AC | C8678 (https://lcsc.com/product-detail/Schottky-Barrier-Diodes-SBD_MDD-Microdiode-Electronics-SS34_C8678.html/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)
TB6612FNG | IC2 | SSOP24 | C141517 (https://lcsc.com/product-detail/Motor-Drivers_TOSHIBA_TB6612FNG-C-8-EL_TOSHIBA-TB6612FNG-C-8-EL_C141517.html/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)
TPS61230DRCR | U2 | SON50P300X300X100-11N | C139626 (https://lcsc.com/product-detail/DC-DC-Converters_TI_TPS61230DRCR_TPS61230DRCR_C139626.html/?href=jlc-SMT)
WHT | LED1 | CHIP-LED0805 | C34499 (https://lcsc.com/product-detail/Light-Emitting-Diodes-LED_white-0805_C34499.html/?href=jlc-SMT)
X322512MSB4SI | X2 | X3225_4P | C9002 (https://lcsc.com/product-detail/SMD-Crystal-Resonators_Yangxing-Tech-X322512MSB4SI_C9002.html/?href=jlc-SMT)
YEL | LED8 | CHIP-LED0805 | C2296 (https://lcsc.com/product-detail/Light-Emitting-Diodes-LED_Yellow-light-0805-Highlighted_C2296.html/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)
YNR3015-1R0M | L1 | L_NR40XX | C340357
