metaboonma/MR32-BOT/Eagle_MR32-BOT/Mini-32BOT Rev.A.brd

## EAGLE design Eagle_MR32-BOT/Mini-32BOT Rev.A.brd (2020-05-31)

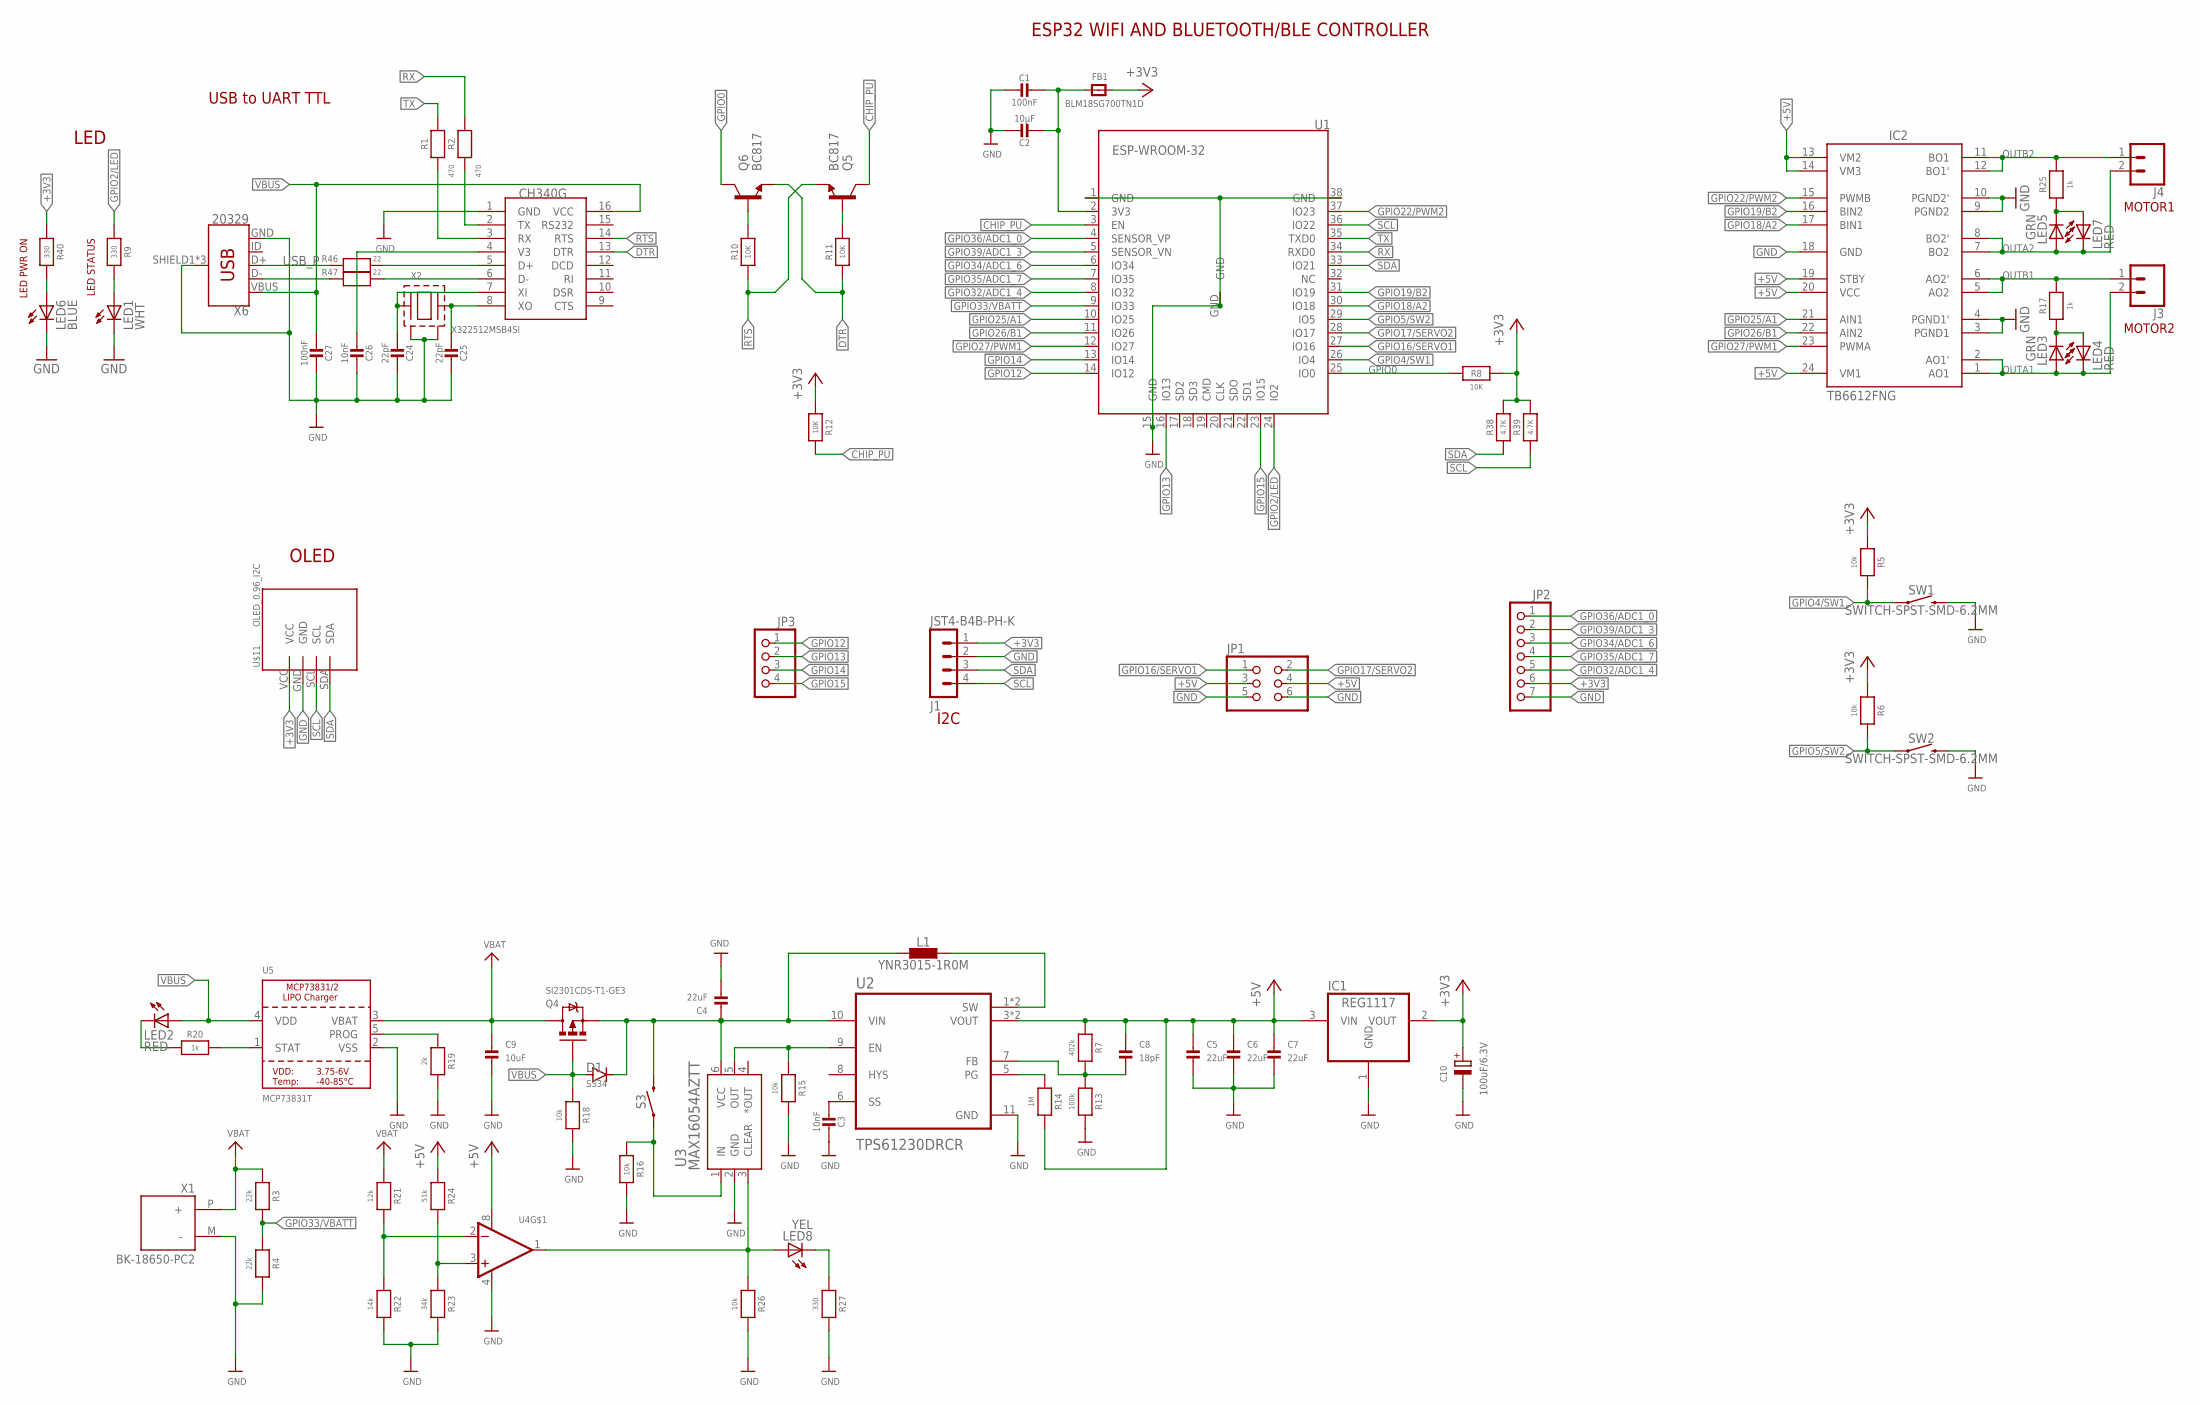
[picture p26: schematic Mini-32BOT Rev.A.sch]

Parts:
C1, C27: 100nF; 0603
C2: 10µF; 0805
C3, C26: 10nF; 0603
C4, C5, C6, C7: 22uF; 0805
C8: 18pF; 0603
C9: 10uF; 0805
C10: 100uF/6.3V; CT3528
C24, C25: 22pF; 0603
D1: SS34; DO-214AC
FB1: BLM18SG700TN1D; _0603
IC1: REG1117; SOT223
IC2: TB6612FNG; SSOP24
J1: JST4-B4B-PH-K; JST_B4B-PH-K
J3, J4: CONN_023.5MM; SCREWTERMINAL-3.5MM-2
JP1: PINHD-2X03_2.54; 2X03
JP2: PINHD-1X07_2.54-S; 1X07-S
JP3: PINHD-1X04_2.54-S; 1X04-S
L1: YNR3015-1R0M; L_NR40XX
LED1: WHT; CHIP-LED0805
LED2, LED4, LED7: RED; CHIP-LED0805
LED3, LED5: GRN; CHIP-LED0805
LED6: BLUE; CHIP-LED0805
LED8: YEL; CHIP-LED0805
Q4: SI2301CDS-T1-GE3; SOT23-3
Q5, Q6: BC817; SOT23-3
R1, R2: 470; 0603
R3, R4: 22k; 0603
R5, R6, R15, R16, R18, R26: 10k; 0603
R7: 402k; 0603
R8, R10, R11, R12: 10K; 0603
R9, R27, R40: 330; 0603
R13: 100k; 0603
R14: 1M; 0603
R17, R20, R25: 1k; 0603
R19: 2k; 0603
R21: 12k; 0603
R22: 14k; 0603
R23: 34k; 0603
R24: 51k; 0603
R38, R39: 4.7K; 0603
R46, R47: 22; 0603
S3: MOMENTARY-SWITCH-SPST-PTH-RIGHT-ANGLE-KIT; TACTILE_SWITCH_PTH_RIGHT_ANGLE_KIT
SW1, SW2: SWITCH-SPST-SMD-6.2MM; TACTILE_SWITCH_SMD_6.2MM_TALL
U1: ESP-WROOM-32
U2: TPS61230DRCR; SON50P300X300X100-11N
U3: MAX16054AZTT; 21-0114C
U4: LM358; SOIC8_150MIL
U5: MCP73831T; SOT23-5
U$11: OLED_0.96_I2C
U$24: CH340G; SOIC16
X1: BK-18650-PC2; MPD_BK-18650-PC2
X2: X322512MSB4SI; X3225_4P
X6: 20329; USB-B-MICRO-SMD

Connections:
3V3: C1.1, C2.2, FB1.1, U1.2 (3V3)
+3V3: C10.+, FB1.2, IC1.2 (VOUT), J1.1, JP2.6, R5.1, R6.1, R8.2, R12.1, R38.2, R39.2, R40.1, U$11.VCC
+5V: C5.1, C6.1, C7.1, C8.1, IC1.3 (VIN), IC2.13 (VM2), IC2.14 (VM3), IC2.19 (STBY), IC2.20 (VCC), IC2.24 (VM1), JP1.3, JP1.4, R7.1, R14.2, R24.1, U2.3 (VOUT), U2.4 (VOUT), U4.8 (V+)
CHIP_PU: Q5.3 (C), R12.2, U1.3 (EN)
DTR: Q6.2 (E), R11.1, U$24.13 (DTR)
GND: C1.2, C2.1, C3.1, C4.2, C5.2, C6.2, C7.2, C9.2, C10.-, C24.1, C25.1, C26.1, C27.1, IC1.1 (GND), IC2.3 (PGND1), IC2.4 (PGND1'), IC2.9 (PGND2), IC2.10 (PGND2'), IC2.18 (GND), J1.2, JP1.5, JP1.6, JP2.7, LED1.C, LED6.C, R4.2, R13.2, R15.2, R16.2, R18.2, R19.2, R22.2, R23.2, R26.2, R27.2, SW1.B2 (2), SW2.B2 (2), U1.1 (GND), U1.15 (GND), U1.38 (GND), U1.GND, U2.11 (GND), U3.2 (GND), U4.4 (V-), U5.2 (VSS), U$11.GND, U$24.1 (GND), X1.M (-), X2.P$2 (GND1), X2.P$4 (GND2), X6.GND, X6.SHIELD1 (SHIELD), X6.SHIELD2 (SHIELD), X6.SHIELD3 (SHIELD)
GPIO0: Q6.3 (C), R8.1, U1.25 (IO0)
GPIO2/LED: R9.1, U1.24 (IO2)
GPIO4/SW1: R5.2, SW1.A2 (1), U1.26 (IO4)
GPIO5/SW2: R6.2, SW2.A2 (1), U1.29 (IO5)
GPIO12: JP3.1, U1.14 (IO12)
GPIO13: JP3.2, U1.16 (IO13)
GPIO14: JP3.3, U1.13 (IO14)
GPIO15: JP3.4, U1.23 (IO15)
GPIO16/SERVO1: JP1.1, U1.27 (IO16)
GPIO17/SERVO2: JP1.2, U1.28 (IO17)
GPIO18/A2: IC2.17 (BIN1), U1.30 (IO18)
GPIO19/B2: IC2.16 (BIN2), U1.31 (IO19)
GPIO22/PWM2: IC2.15 (PWMB), U1.37 (IO23)
GPIO25/A1: IC2.21 (AIN1), U1.10 (IO25)
GPIO26/B1: IC2.22 (AIN2), U1.11 (IO26)
GPIO27/PWM1: IC2.23 (PWMA), U1.12 (IO27)
GPIO32/ADC1_4: JP2.5, U1.8 (IO32)
GPIO33/VBATT: R3.2, R4.1, U1.9 (IO33)
GPIO34/ADC1_6: JP2.3, U1.6 (IO34)
GPIO35/ADC1_7: JP2.4, U1.7 (IO35)
GPIO36/ADC1_0: JP2.1, U1.4 (SENSOR_VP)
GPIO39/ADC1_3: JP2.2, U1.5 (SENSOR_VN)
unnamed: C4.1, D1.C, L1.1, Q4.2 (S), S3.2, U2.10 (VIN), U3.6 (VCC)
unnamed: C3.2, U2.6 (SS)
unnamed: L1.2, U2.1 (SW), U2.2 (SW)
unnamed: R15.1, U2.9 (EN), U3.5 (OUT)
unnamed: C8.2, R7.2, R13.1, U2.7 (FB)
unnamed: R14.1, U2.5 (PG)
unnamed: R16.1, S3.1, U3.1 (IN)
unnamed: R21.2, R22.1, U4.2 (-IN)
unnamed: R23.1, R24.2, U4.3 (+IN)
unnamed: LED8.A, R26.1, U3.3 (CLEAR), U4.1 (OUT)
unnamed: LED3.C, LED4.A, R17.1
unnamed: LED5.C, LED7.A, R25.1
unnamed: R19.1, U5.5 (PROG)
unnamed: C25.2, U$24.8 (XO), X2.P$3
unnamed: LED2.C, R20.1
unnamed: R20.2, U5.1 (STAT)
unnamed: C24.2, U$24.7 (XI), X2.P$1
unnamed: LED8.C, R27.1
unnamed: LED1.A, R9.2
unnamed: LED6.A, R40.2
unnamed: Q5.1 (B), R11.2
unnamed: C26.2, U$24.4 (V3)
unnamed: Q6.1 (B), R10.2
unnamed: R2.1, U$24.2 (TX)
unnamed: R1.1, U$24.3 (RX)
unnamed: R46.1, U$24.5 (D+)
unnamed: R47.1, U$24.6 (D-)
OUTA1: IC2.1 (AO1), IC2.2 (AO1'), J3.2, LED3.A, LED4.C
OUTA2: IC2.7 (BO2), IC2.8 (BO2'), J4.2, LED5.A, LED7.C
OUTB1: IC2.5 (AO2), IC2.6 (AO2'), J3.1, R17.2
OUTB2: IC2.11 (BO1), IC2.12 (BO1'), J4.1, R25.2
RTS: Q5.2 (E), R10.1, U$24.14 (RTS)
RX: R2.2, U1.34 (RXD0)
SCL: J1.4, R39.1, U1.36 (IO22), U$11.SCL
SDA: J1.3, R38.1, U1.33 (IO21), U$11.SDA
TX: R1.2, U1.35 (TXD0)
USB_N: R47.2, X6.D-
USB_P: R46.2, X6.D+
VBAT: C9.1, Q4.3 (D), R3.1, R21.1, U5.3 (VBAT), X1.P (+)
VBUS: C27.2, D1.A, LED2.A, Q4.1 (G), R18.1, U5.4 (VDD), U$24.16 (VCC), X6.VBUS

Notes on the sheet:
ESP32 WIFI AND BLUETOOTH/BLE CONTROLLER
LED PWR ON
LED STATUS
LED
MOTOR2
MOTOR1
USB to UART TTL
I2C
OLED

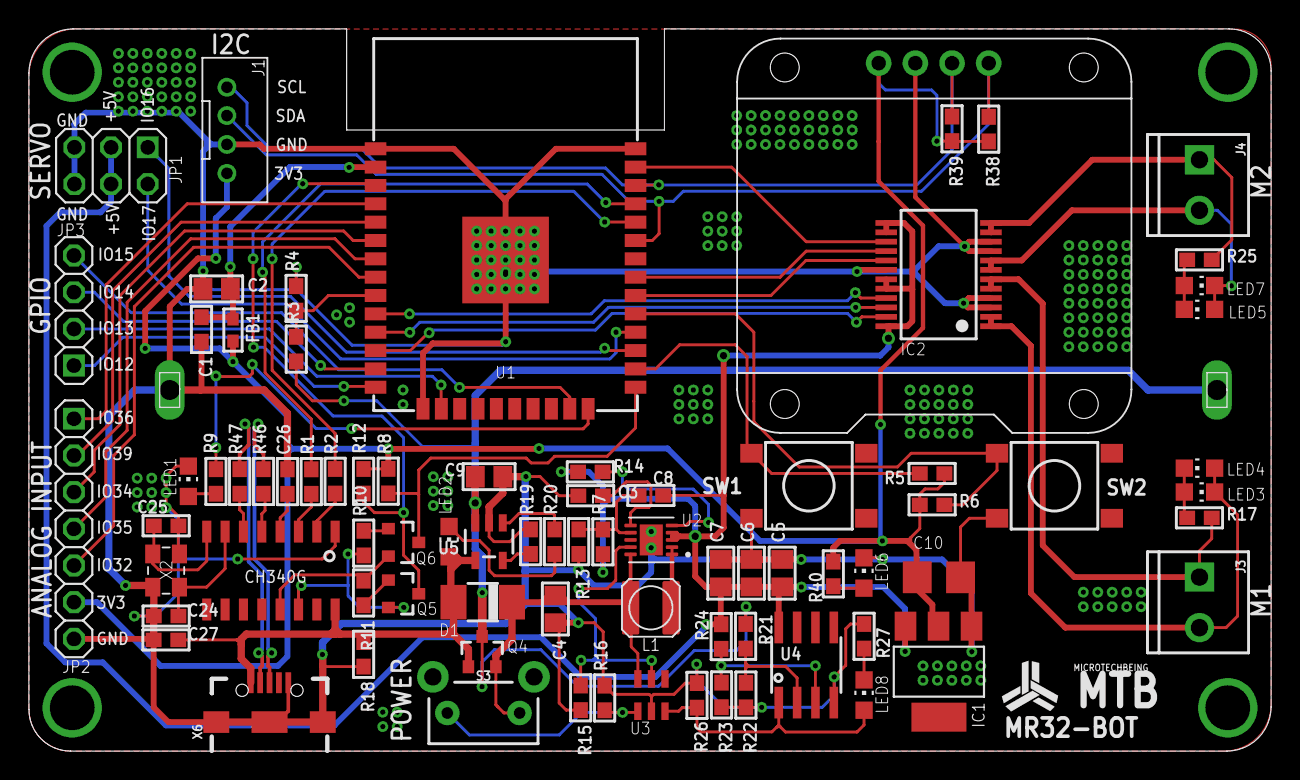
[picture p27: board Mini-32BOT Rev.A.brd from above]

Board: 2 copper layers, 86.0 x 50.0 mm, 81 parts (1 on the bottom side), 68 nets.
