metaboonma/MR32-BOT/(commit log)

2020-05-31 Create new project
    [JLCSMT_MR32-BOT_BOM.xlsx, Mini-32BOT Rev.A.brd, Mini-32BOT Rev.A.sch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]
2020-08-07 Add PPT
    [JLCSMT_MR32-BOT_BOM.xlsx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]
